pcaunegre/SWiM/Anemo.jpg

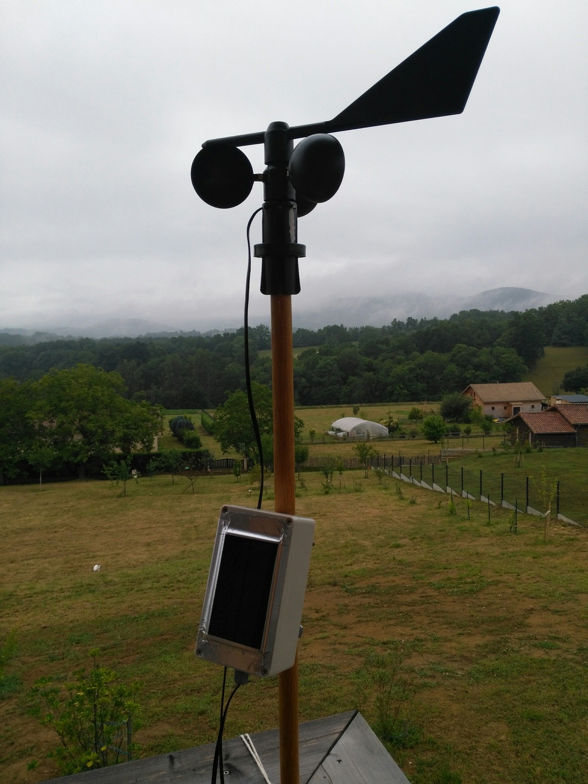
Anemo.jpg
