pcaunegre/SWiM/Anemo_detail.jpg

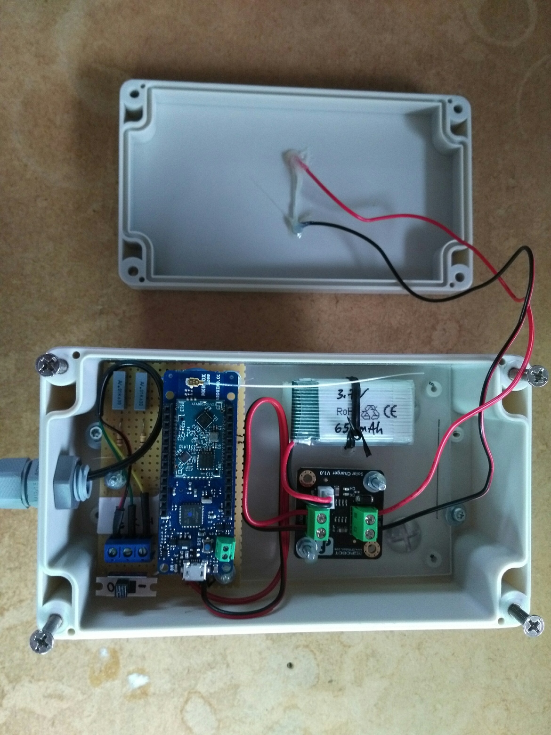
Anemo_detail.jpg
