pcaunegre/SWiM/hardware/SWiM.pdf

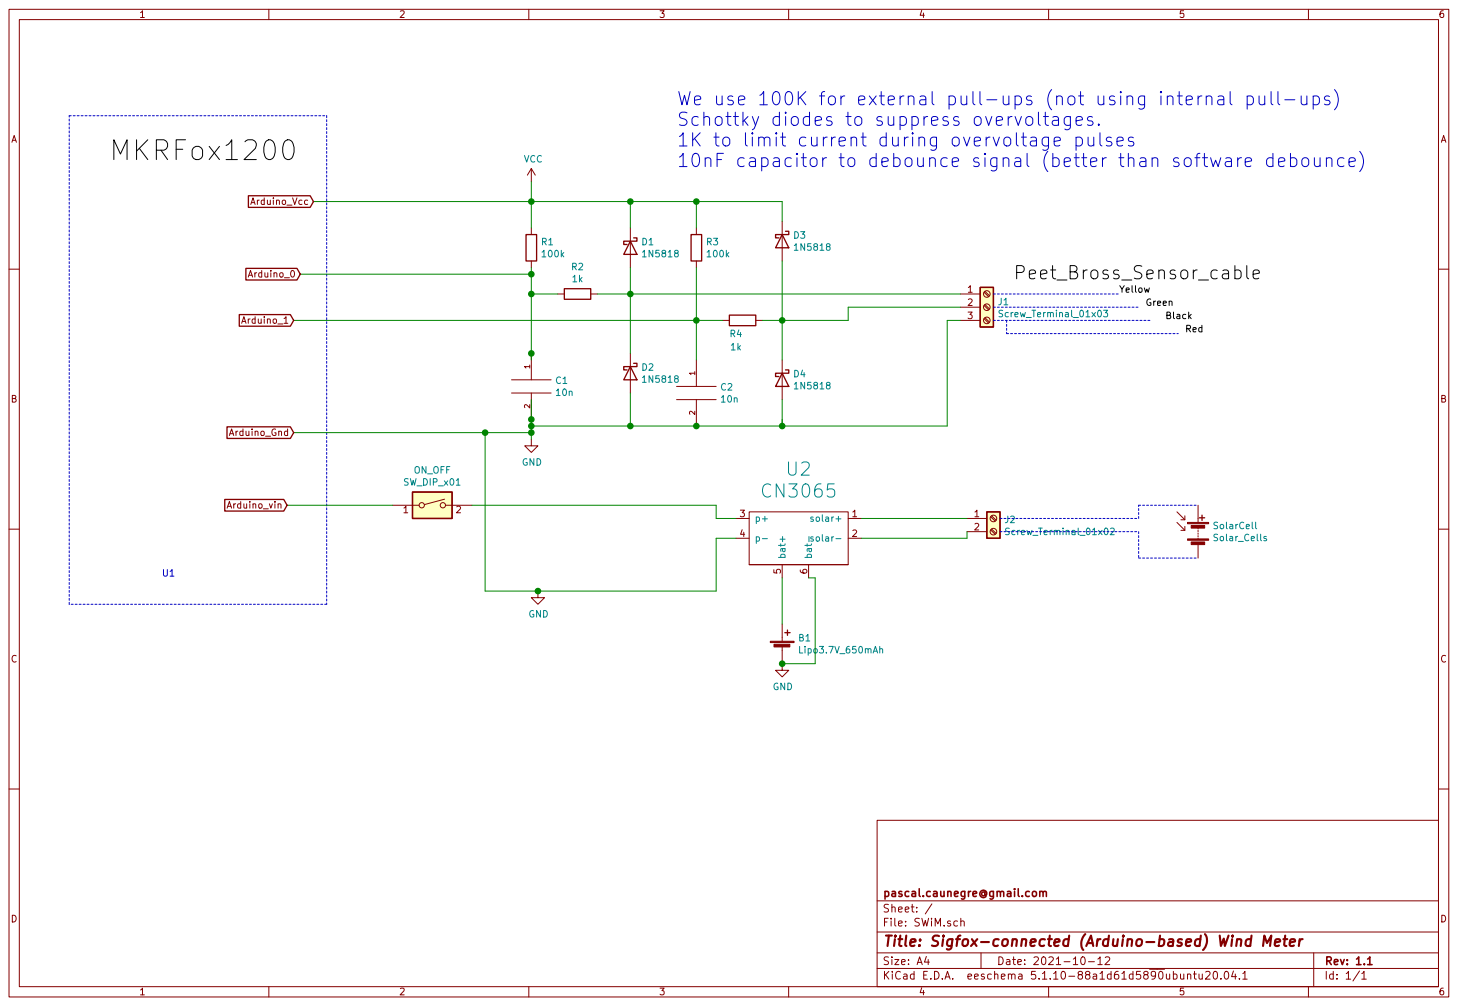
[picture p3: page 1]

We use 100K for external pull-ups (not using internal pull-ups)
Schottky diodes to suppress overvoltages.
1K to limit current during overvoltage pulses

MKRFox1200
10nF capacitor to debounce signal (better than software debounce) U1

Id: 1/1 Title: Sigfox-connected (Arduino-based) Wind Meter File: SWiM.sch Sheet: / pascal.caunegre@gmail.com
