pcaunegre/SWiM/hardware/SWiM.sch

## KiCad design hardware/SWiM.sch (2021-10-12)

Schematic: SWiM.sch

Parts:
B1: Lipo3.7V_650mAh
C1, C2: 10n
D1, D2, D3, D4: 1N5818; D_DO-41_SOD81_P10.16mm_Horizontal
J1: Screw_Terminal_01x03
J2: Screw_Terminal_01x02
ON_OFF: SW_DIP_x01
R1, R3: 100k
R2, R4: 1k
SolarCell: Solar_Cells
U2: CN3065

Notes on the sheet:
We use 100K for external pull-ups (not using internal pull-ups) Schottky diodes to suppress overvoltages. 1K to limit current during overvoltage pulses 10nF capacitor to debounce signal (better than software debounce)
