pcaunegre/SWiM/src/firmware/firmware.ino

/*
* -- Software for Arduino MKRFox1200 --
*
*
* Purpose: Sigfox-connected Wind AnemoMeter based on Peet Bros. (PRO) anemometer
*          sending data to the OpenWindMap network via Sigfox
*          
* Measures available e.g. on https://www.openwindmap.org/PPXXX  
* Full messages on http://api.pioupiou.fr/v1/sigfox-messages/XXX
* (replace XXX by the number of your station obtained by a registration to openwindmap)
* 
* Peet Bros device uses 2 reed contacts, one for speed, one for wind direction
* This program reads the wind speed and direction interrupts from two input pins, compute wind
* and sends data through Sigfox
*
* To upload the code onto the board press 2 times quickly the reset button to activate the bootloader
*
* Pascal Caunegre. pascal.caunegre@gmail.com
*
*/



#include <SigFox.h>
#include <math.h> 
#include "def.h"
#include <LiquidCrystal.h>


volatile unsigned long  timeOffset    ;       // offset of millis time to limit size of times variables

volatile unsigned long  speedLastPulseT  ;    // last time in millis the speed sensor triggers
volatile int            speedTimeArray[ARRAYLEN];  // array to store times of speed sensor pulses
volatile int            speedHitCnt;          // counter of speed pulses
volatile unsigned long  dirLastPulseT  ;      // last time in millis the dir sensor triggers
volatile int            dirTimeArray[ARRAYLEN];    // array to store times of dir sensor pulses
volatile int            dirHitCnt;            // counter of dir pulses
volatile unsigned long  last_sampleT  ;       // last time in millis a measure sampling has been done
volatile unsigned long  last_reportT  ;       // last time in millis a sigfox telegram has been sent

volatile int            max_wspeed    ;  // max wind speed over the sample period
volatile int            min_wspeed    ;  // min wind speed over the sample period
volatile int            cnt_ws_samples;  // count the number of samples we have to compute speed avg
volatile int            cnt_wd_samples;  // count the number of samples we have to compute dir avg
volatile int            acc_wspeed    ;  // wind speed accumulator to compute avg
volatile float          acc_wdX       ;  // accumulate wind dir projection on X axis (cos)
volatile float          acc_wdY       ;  // accumulate wind dir projection on X axis (sin)
volatile int            prevWindDir   ;  // memorize the last dir in case we cannot compute new one (speed too low)
volatile int            statReportCnt ;  // counter : every 2 hits data are sent thru sigfox 

volatile int            cpudiv        ;  // value of cpu freq divisor
volatile int            lognbr        ;  // number of logs
volatile int            repnbr        ;  // number of logs
volatile bool           debugmode     ;  // 1=debug mode
volatile bool           lcd_en        ;  // lcd plugged or not
volatile SigfoxWindMessage msg        ;  // create an instance of the struct to receive the wind data frame

// optional display that can be plugged to read values during installation
LiquidCrystal lcd(9, 8, 5, 4, 3, 2);

void setup() {

  // pins to sensor
  pinMode(pinSpeed, INPUT); // yellow wire of Peet Bros cable
  pinMode(pinDir  , INPUT); // green  wire
  pinMode(Led,     OUTPUT); // led used for debug or at power up
  
  // init variables
  cpudiv           = CPU_FULL;
  speedLastPulseT  = 0;
  dirLastPulseT    = 0;
  speedHitCnt      = 0;
  dirHitCnt        = 0;
  statReportCnt    = 0;
  clearArrays();
  reset_stat();  
  prevWindDir      = -1;
  timeOffset       = millis();
  debugmode        = DEBUG;
  lcd_en           = LCD;
  lognbr           = 0;
  repnbr           = 0;
  
  // in debug mode we send back logs to the PC in Arduino IDE via Serial
  DebugInit();
    
  blinkLed(5,200/cpudiv); // blinks 5 times to say power is ok  

  // for future: sending proprietary infos at startup
  // sendPropInfos();    

  // install interruptions functions
  attachInterrupt(digitalPinToInterrupt(pinSpeed), isr_speed    , FALLING);
  attachInterrupt(digitalPinToInterrupt(pinDir)  , isr_direction, FALLING);
  
  set_cpu_speed(CPU_SLOW);
  
}


void loop() {

  unsigned long now = millis();
  int    dt1 = now - last_sampleT;  // ellapsed time since last sample
  int    dt2 = now - last_reportT;  // ellapsed time since last report  
  
  // if it's time to sample, get measures and store for stats
  if (dt1 > SAMPLING_PERIOD/cpudiv) {
    takeSample();
  }

  // at every sigfox report period we send 2 packets of data
  // so at every half-report period we store data
  if (dt2 > (REPORT_PERIOD/2)/cpudiv) {
    makeReport();
  }

  if (now > REBOOT_PERIOD/cpudiv) reboot(); // avoid managing millis value wrapping (every 2**32-1 ms)


}

/*
 * Take sample
 * capture one measure point
 *
*/
void takeSample() {
  
  unsigned long now = millis();
  int ws, wd;
  
  last_sampleT = now;
  noInterrupts();
  timeOffset = now;
  ws = computeWindSpeed();
  wd = computeWindDir();
  store_for_stat(ws,wd);
  DebugLogMeas(ws,wd); // only for reading through lcd display or via usb
  resetSampler();
  if (debugmode) blinkLed(1,100/cpudiv); // debug purpose
  interrupts();
    
}
/*
 * compute measure stat and prepare and send report to sigfox module
 * 
 *
*/
void makeReport() {
  
  int ws, wd;
    
  // report the values
  ws = wspeed_avg();
  wd = wdir_avg();
  
  // store in msg structure with OpenWindMap-expected data encoding
  msg.speedMin[statReportCnt]     = encodeWindSpeed(min_wspeed);
  msg.speedAvg[statReportCnt]     = encodeWindSpeed(ws);
  msg.speedMax[statReportCnt]     = encodeWindSpeed(max_wspeed);
  msg.directionAvg[statReportCnt] = encodeWindDirection(wd);
  
  DebugLogAvgMeas(ws,wd); // only for reading through lcd display or via usb 

  // we send telegram half the time
  if (statReportCnt==1) {
    // send sigfox telegram
    
    DebugSimSigfoxSend();
    
    // Sigfox call, will require normal cpu rate
    noInterrupts();  // hold on interruptions
    if (debugmode) blinkLed(3,100/cpudiv);
    set_cpu_speed(CPU_FULL);
    sendSigFoxMessage();
    set_cpu_speed(CPU_SLOW);
    interrupts();   // resume interruptions
    
    statReportCnt=0;
  } else {
    statReportCnt=1;
  }
  
  // clear stats
  reset_stat();
  
  // reset the clocks
  last_reportT = millis();
  last_sampleT = last_reportT;
 
}

/*
 * Interrupt service routine called when the rotating part of the wind instrument
 * has completed one rotation.
 *
*/
void isr_speed() {
  int now = millis();
  
  // avoid switch bounce to call this routine multiple times
  if ((now - speedLastPulseT) < DEBOUNCE_TIME/cpudiv) {
    return;
  }
  speedLastPulseT = now; 
  speedTimeArray[speedHitCnt] = now-timeOffset;
  speedHitCnt++;

}
/*
 * Interrupt service routine called when the direction reed sensor triggers.
 *
*/
void isr_direction() {
  int now = millis();
  
  // avoid switch bounce to call this routine multiple times
  if ((now - dirLastPulseT) < DEBOUNCE_TIME/cpudiv) {
    return;
  }
  dirLastPulseT = now;   
  dirTimeArray[dirHitCnt] = now-timeOffset;
  dirHitCnt++;

}
/*
 * Accessory to reset the arrays.
 *
*/
void clearArrays() {
  for (int i = 0; i < ARRAYLEN; i++) {
    speedTimeArray[i]=0;
    dirTimeArray[i]=0;
  }
}
/*
 * Accessory to reset the sampler variables.
 *
*/
void resetSampler() {

  clearArrays();
  speedHitCnt = 0;
  dirHitCnt   = 0;
    
}


// /*
//  * Compute the wind speed and dir over the sample period.
//  *
//  * update the ws and wd global vars
// */
int computeWindSpeed() {
  
  float mph;
   
  // not enough pulses to compute wind
  if (speedHitCnt<2) return(-1);
  
  // rotation per seconds
  int dt = (speedTimeArray[speedHitCnt-1]-speedTimeArray[0])*cpudiv;
  float rps = 1000.0 * (float)(speedHitCnt-1) / (float)dt;
  
  // calibration formulas given by Peet Bros sensor vendor
  // calibration formulas given by Peet Bros sensor vendor
  if      (rps < 0.010)  mph = 0.0;
  else if (rps < 3.229)  mph = -0.1095*rps*rps + 2.9318*rps - 0.1412;
  else if (rps < 54.362) mph =  0.0052*rps*rps + 2.1980*rps + 1.1091; // 54rps is 216km/h !
  // useless: the sensor will be destroyed before this wind speed !
  //else if (rps < 66.332) mph =  0.1104*rps*rps - 9.5685*rps + 329.87;
  
  int kmh = int(mph * 1.609344);  // be aware the sensor doc is wrong on that conversion !
  return(kmh);
}


// /*
//  * Compute the wind dir over the sample period.
//  *
// */
int computeWindDir() {
  int   wdir=-1;         // wind dir in degree to return
  int   dp;              // time of wind dir pulse
  float acc_ratio = 0.0; // sum of dir/speed times ratio to average over the sampling period
  int   hitCnt      = 0; // nbr of elements in the average calc
  
  // not enough pulses to compute wind
  if (speedHitCnt<2) return(wdir);
  
  for (int i = 0; i < speedHitCnt-1; i++) {
    // look for a dir pulse comprised between two bounds of speed pulses
    dp=searchElem(speedTimeArray[i],speedTimeArray[i+1]);
  
    if (dp>0) {
        acc_ratio += (float)(dp - speedTimeArray[i]) / (float)(speedTimeArray[i+1]-speedTimeArray[i]);
        hitCnt++;
    }
  }
  if (!hitCnt) return(wdir); // not possible to compute wind direction
  
  wdir = int(360 * acc_ratio / hitCnt);

  return(wdir);
}

/*
 * Accessory to search in the Dir pulse times array
 * a value between LL and UL
 * 
*/
int searchElem(int LL, int UL) {

  for (int i=0; i<dirHitCnt; i++ ) {
    if (dirTimeArray[i]> UL)  return(0); // 
    if ((dirTimeArray[i] >= LL) && (dirTimeArray[i] <= UL)) {
        return(dirTimeArray[i]);
    }
  }
  return(0);
}


/*
 * Take measures and compute some statistics over a report period
 * min, max, accumulate for average, mean wind dir
 * 
*/
void store_for_stat(int ws, int wd)  {
  // wind speed in km/h
  // wind dir in degrees
  // -1 means meas not valid
  
  if (ws>-1)  {
    if (ws > max_wspeed)  max_wspeed = ws;
    if (ws < min_wspeed)  min_wspeed = ws;
    acc_wspeed += ws;
    cnt_ws_samples++;
  }
  
  if (wd>-1)  {
    // projection of direction is weighted by the speed
    acc_wdX += ws * cos(PI*wd/180.);
    acc_wdY += ws * sin(PI*wd/180.);
    cnt_wd_samples++;
  }

}
/*
 * Resets all counters and accumulator when a report has been done
 * min, max, accumulate for average, mean wind dir
 * 
*/
void reset_stat()  {
  max_wspeed    = 0  ;
  min_wspeed    = 999;
  acc_wspeed    = 0  ;
  cnt_ws_samples= 0  ;
  cnt_wd_samples= 0  ;
  acc_wdX       = 0.0;
  acc_wdY       = 0.0;

}

/*
 * Computes avg wind speed
*/
int wspeed_avg()  {
    return(int(acc_wspeed/cnt_ws_samples));
}

/*
 * Computes avg wind direction
*/
int wdir_avg()  {
    int avgdir; 
    
    // when no dir samples, keep the previous direction
    if (!cnt_wd_samples) return(prevWindDir);
    
    avgdir = int(atan2(acc_wdY,acc_wdX)*180/PI);
    if (avgdir<0)  avgdir += 360;
    prevWindDir = avgdir;   // store this in a globvar
    
    return(avgdir);
}


/*
 * functions dedicated to Sigfox message sending
 * 
 *speedMin[0], speedMin[1], speedAvg[0], speedAvg[1], speedMax[0], speedMax[1], dirAvg[0], dirAvg[1]
*/
void sendSigFoxMessage() {
  // Start the module  
    
  delay(10);
  SigFox.begin();
//   if (!SigFox.begin()) {
//     Serial.println("SigFox error, rebooting");
//     reboot();
//   }
  // Wait at least 30mS after first configuration (100mS before)
  delay(100);
  SigFox.debug();

  // Clears all pending interrupts
  SigFox.status();
  delay(1);
  SigFox.beginPacket();
  
  // OpenWindMap specific data frame  
  SigFox.write((uint8_t*)&msg, sizeof(SigfoxWindMessage));
  
  int ret = SigFox.endPacket();
  SigFox.end();
}


/*
 * system functions
*/
void reboot() {
  NVIC_SystemReset();
  while (1);
}

/*
 * CPU underclocking: clock is divided by divisor
*/
void set_cpu_speed(int divisor){
  cpudiv=divisor;
  GCLK->GENDIV.reg = GCLK_GENDIV_DIV(divisor) |         // Divide the 48MHz clock source by divisor 48: 48MHz/48=1MHz
                   GCLK_GENDIV_ID(0);            // Select Generic Clock (GCLK) 0
  while (GCLK->STATUS.bit.SYNCBUSY);               // Wait for synchronization      
}



///*
// * function to collect and send a proprietary monitoring infos
// * 
//*/
//void sendPropInfos()  {
//
//  // measure V battery
//  analogReference(AR_INTERNAL1V65); // use internal 1.65 Vref
//  analogReadResolution(10);
//  uint16_t val ; 
//  delay(10);
//  val = 0;
//  for (byte i=0;i<10;i++) {
//      val = val + analogRead(pinBattV);
//      delay(10);
//  }
//
//  float vbat = (float)val*1.65/40950; // ADC full range 4095
//  vbat = vbat*0.9567+0.0063;          // Calibration of ADC
//  vbat = vbat*3.383;                  // ratio of R divisor
//  byte vbf = int((vbat-1.5)*100);     // encoding on 1 byte 0:255 for 1.5V:4.05V
//
//  // send infos to sigfox
//  
//}
///*
// * function to send a proprietary 12 bits message for monitoring
// * 
//*/
//void sendInitSigfoxMessage() {
//  delay(10);
//  SigFox.begin();
//  delay(100);
//  SigFox.debug();
//  SigFox.status();
//  delay(1);
//  SigFox.beginPacket();
//  
//  // Payload to be defined
//  int a=1; 
//  SigFox.write((uint8_t)a);
//  a=2 ;
//  SigFox.write((uint8_t)a);
//  a=3 ;
//  SigFox.write((uint8_t)a);
//  a=4 ;
//  SigFox.write((uint8_t)a);
//  a=5 ;
//  SigFox.write((uint8_t)a);
//  a=6 ;
//  SigFox.write((uint8_t)a);
//  a=7;
//  SigFox.write((uint8_t)a);
//  a=8 ;
//  SigFox.write((uint8_t)a);
//  a=9 ;
//  SigFox.write((uint8_t)a);
//  a=10 ;
//  SigFox.write((uint8_t)a);
//  a=11 ;
//  SigFox.write((uint8_t)a);
//  a=12 ;
//  SigFox.write((uint8_t)a);
//  
//  int ret = SigFox.endPacket();
//  SigFox.end();
//
//}
