pcaunegre/SWiM/(commit log)

2021-06-22 added CPU underclocking. Now I=4.3mA instead of 14m.
2021-07-31 added hardware schematic
2021-08-13 schematic eeschema file
    [SWiM.sch]
2021-08-16 comments added
    [SWiM.sch]
2021-08-16 BOM update
2021-08-16 fixed bug of min value showing 0 every 10min
    [firmware.ino]
2021-08-16 synchronized report and samples so that sample period is not truncated by sigfox tx
2021-08-16 fixed bug of min value showing 0 every 10min
    synchronized report and samples reset so that sample period is not truncated by sigfox transmission
    (not tested)
    [firmware.ino]
2021-10-12 fixed numbering+little change
    [SWiM.sch]
2021-10-12 Schematic improved and clarified device numbering
    [SWiM.sch]
